tivanis/HVDiffprobe/Differential_Probe_v1r1.kicad_pcb

## KiCad design Differential_Probe_v1r1.kicad_pcb (2024-01-04)

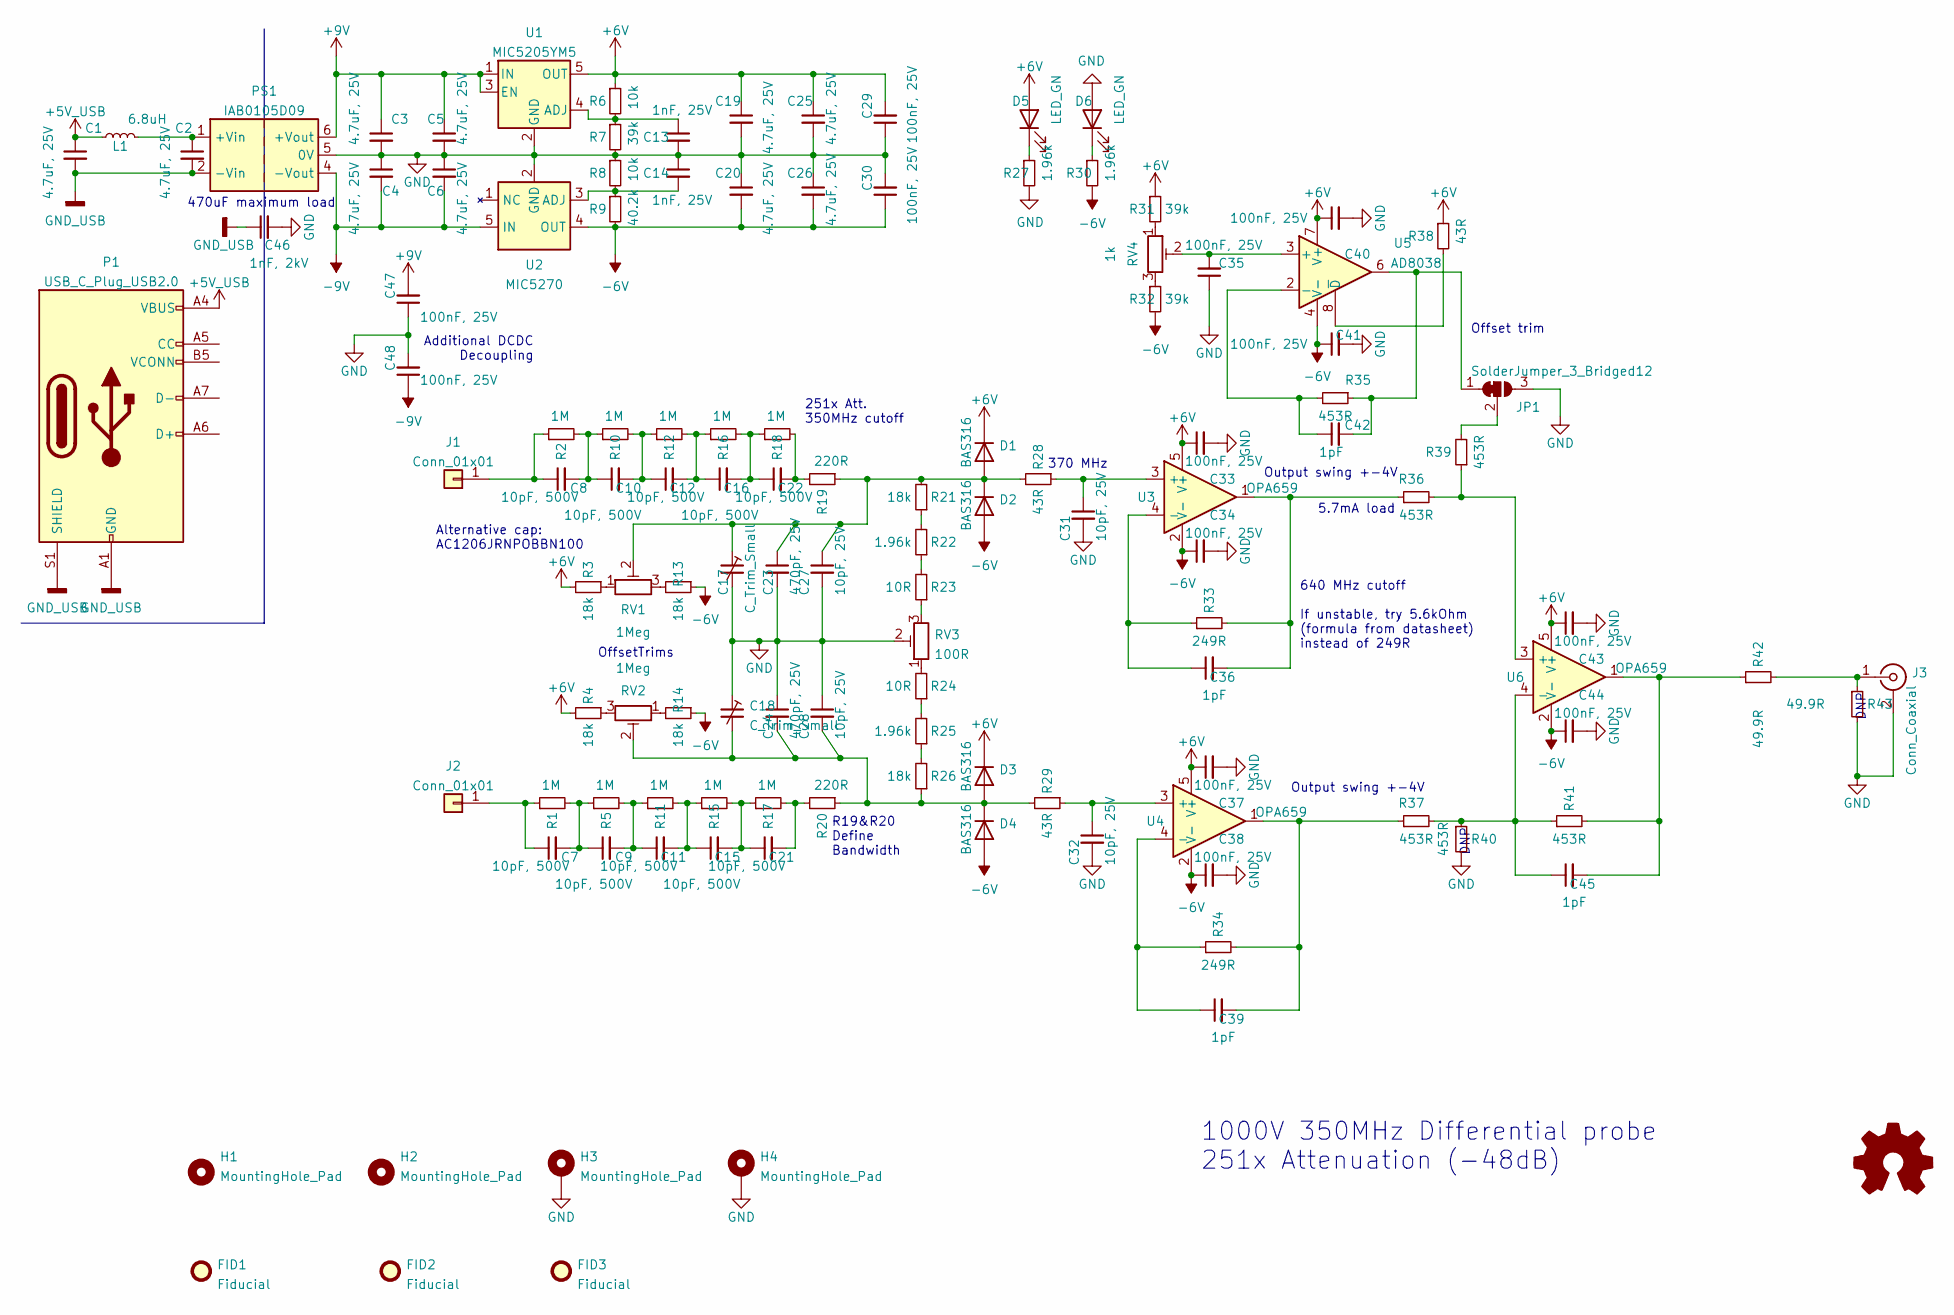
[picture p1: schematic Differential_Probe_v1r1.kicad_sch]

Parts:
C1, C2, C3, C4, C5, C6, C19, C20, C25, C26: 4.7uF, 25V; C_0805_2012Metric; Manufacturer Part Number TMK212BBJ475KGHT
C7, C8, C9, C10, C11, C12, C15, C16, C21, C22: 10pF, 500V; C_1206_3216Metric; Manufacturer Part Number 1206N100G501CT
C13, C14: 1nF, 25V; C_0603_1608Metric; Manufacturer Part Number C0603C102K3RAC
C17, C18: C_Trim_Small; C_Trimmer_Voltronics_JZ; Manufacturer Part Number JZ400
C23, C24: 470pF, 25V; C_0603_1608Metric; Manufacturer Part Number VJ0603A471GXXCW1BC
C27, C28, C31, C32: 10pF, 25V; C_0603_1608Metric; Manufacturer Part Number CL03C100DA3GNNC
C29, C30, C33, C34, C35, C37, C38, C40, C41, C43, C44, C47, C48: 100nF, 25V; C_0603_1608Metric; Manufacturer Part Number CC0603MRX7R8BB104
C36, C39, C42, C45: 1pF; C_0603_1608Metric; Manufacturer Part Number 06033A1R0CAT2A
C46: 1nF, 2kV; C_1812_4532Metric_Pad1.57x3.40mm_HandSolder; Manufacturer Part Number VJ2008Y102KXUSTX1
D1, D2, D3, D4: BAS316; D_SOD-323; Manufacturer Part Number BAS316,135
D5, D6: LED_GN; LED_0603_1608Metric; Manufacturer Part Number APT1608SGC
FID1, FID2, FID3: Fiducial; Fiducial_0.5mm_Mask1mm
H1, H2: MountingHole_Pad; MountingHole_3.2mm_M3
H3, H4: MountingHole_Pad; MountingHole_3.2mm_M3_Pad_Via
J1, J2: Conn_01x01; MountingHole_2.2mm_M2_Pad_Via
J3: Conn_Coaxial; BNC_MOLEX_73100-0154_Horizontal; Manufacturer Part Number 73100-0154
JP1: SolderJumper_3_Bridged12; SolderJumper-3_P1.3mm_Open_RoundedPad1.0x1.5mm
L1: 6.8uH; L_1008_2520Metric; Manufacturer Part Number VLS201610HBX-6R8M-1
P1: USB_C_Plug_USB2.0; USB_C_Receptacle_GCT_USB4085; Manufacturer Part Number USB4085-GF-A
PS1: IAB0105D09; Converter_DCDC_XP_POWER-IAxxxxS_THT; Manufacturer Part Number IAB0105D09
R1, R2, R5, R10, R11, R12, R15, R16, R17, R18: 1M; R_1206_3216Metric; Manufacturer Part Number KTR18EZPF1004
R3, R4, R13, R14, R21, R26: 18k; R_0603_1608Metric; Manufacturer Part Number CR0603-FX-1802ELF
R6, R8: 10k; R_0603_1608Metric; Manufacturer Part Number CR0603-FX-1501ELF
R7, R31, R32: 39k; R_0603_1608Metric; Manufacturer Part Number CR0603-FX-3902ELF
R9: 40.2k; R_0603_1608Metric; Manufacturer Part Number CR0603-FX-1501ELF
R19, R20: 220R; R_0603_1608Metric; Manufacturer Part Number ERJ-PA3F2200V
R22, R25, R27, R30: 1.96k; R_0603_1608Metric; Manufacturer Part Number CR0603-FX-1961ELF
R23, R24: 10R; R_0603_1608Metric; Manufacturer Part Number CR0603-FX-10R0ELF
R28, R29, R38: 43R; R_0603_1608Metric; Manufacturer Part Number CR0603-FX-43R0ELF
R33, R34: 249R; R_0603_1608Metric; Manufacturer Part Number CR0603-FX-2490ELF
R35, R36, R37, R39, R40, R41: 453R; R_0603_1608Metric; Manufacturer Part Number CR0603-FX-4530ELF
R42, R43: 49.9R; R_0603_1608Metric; Manufacturer Part Number CR0603-FX-43R0ELF
RV1, RV2: 1Meg; Potentiometer_Bourns_3314G_Vertical; Manufacturer Part Number TC33X-2-105G
RV3: 100R; Potentiometer_Bourns_3314G_Vertical; Manufacturer Part Number TC33X-2-101E
RV4: 1k; Potentiometer_Bourns_3314G_Vertical; Manufacturer Part Number TC33X-2-103G
U1: MIC5205YM5; SOT-23-5; Manufacturer Part Number MIC5205YM5
U2: MIC5270; SOT-23-5; Manufacturer Part Number MIC5270YM5-TR
U3, U4, U6: OPA659; SOT-23-5; Manufacturer Part Number OPA659IDBVT
U5: AD8038; SOIC-8_3.9x4.9mm_P1.27mm

Connections:
+5V_USB: C1.1, L1.1, P1.A4 (VBUS), P1.A9 (VBUS), P1.B4 (VBUS), P1.B9 (VBUS)
+6V: C19.1, C25.1, C29.2, C33.1, C37.1, C40.1, C43.1, D1.1 (K), D3.1 (K), D5.2 (A), R3.2, R4.2, R6.1, R31.1, R38.1, U1.5 (OUT), U3.5 (V+), U4.5 (V+), U5.7 (V+), U6.5 (V+)
+9V: C3.1, C5.1, C47.2, PS1.6 (+Vout), U1.1 (IN), U1.3 (EN)
-6V: C20.2, C26.2, C30.1, C34.1, C38.1, C41.1, C44.1, D2.2 (A), D4.2 (A), R9.2, R13.1, R14.1, R30.2, R32.2, U2.4 (OUT), U3.2 (V-), U4.2 (V-), U5.4 (V-), U6.2 (V-)
-9V: C4.2, C6.2, C48.1, PS1.4 (-Vout), U2.5 (IN)
GND: C3.2, C4.1, C5.2, C6.1, C13.2, C14.1, C17.2, C18.1, C19.2, C20.1, C23.2, C24.1, C25.2, C26.1, C27.2, C28.1, C29.1, C30.2, C31.2, C32.2, C33.2, C34.2, C35.1, C37.2, C38.2, C40.2, C41.2, C43.2, C44.2, C46.2, C47.1, C48.2, D6.2 (A), H3.1, H4.1, J3.2 (Ext), JP1.3 (B), PS1.5 (0V), R7.2, R8.1, R27.2, R40.2, R43.2, RV3.2, U1.2 (GND), U2.2 (GND)
GND_USB: C1.2, C2.2, C46.1, P1.A1 (GND), P1.A12 (GND), P1.B1 (GND), P1.B12 (GND), P1.S1 (SHIELD), PS1.2 (-Vin)
unnamed: C2.1, L1.2, PS1.1 (+Vin)
unnamed: C7.1, J2.1, R1.1
unnamed: C7.2, C9.1, R1.2, R5.1
unnamed: C8.1, J1.1, R2.1
unnamed: C8.2, C10.1, R2.2, R10.1
unnamed: C10.2, C12.1, R10.2, R12.1
unnamed: C9.2, C11.1, R5.2, R11.1
unnamed: C11.2, C15.1, R11.2, R15.1
unnamed: C12.2, C16.1, R12.2, R16.1
unnamed: C13.1, R6.2, R7.1, U1.4 (ADJ)
unnamed: C14.2, R8.2, R9.1, U2.3 (ADJ)
unnamed: C15.2, C21.1, R15.2, R17.1
unnamed: C16.2, C22.1, R16.2, R18.1
unnamed: C17.1, C23.1, C27.1, D1.2 (A), D2.1 (K), R19.1, R21.2, R28.2, RV1.2
unnamed: C18.2, C24.2, C28.2, D3.2 (A), D4.1 (K), R20.1, R26.1, R29.2, RV2.2
unnamed: C21.2, R17.2, R20.2
unnamed: C22.2, R18.2, R19.2
unnamed: C31.1, R28.1, U3.3 (+)
unnamed: C32.1, R29.1, U4.3 (+)
unnamed: C35.2, RV4.2, U5.3 (+)
unnamed: C36.1, R33.1, U3.4 (-)
unnamed: C36.2, R33.2, R36.1, U3.1
unnamed: C39.1, R34.1, U4.4 (-)
unnamed: C39.2, R34.2, R37.1, U4.1
unnamed: C42.1, R35.2, U5.2 (-)
unnamed: C42.2, JP1.1 (A), R35.1, U5.6
unnamed: C45.1, R37.2, R40.1, R41.1, U6.4 (-)
unnamed: C45.2, R41.2, R42.1, U6.1
unnamed: D5.1 (K), R27.1
unnamed: D6.1 (K), R30.1
unnamed: J3.1 (In), R42.2, R43.1
unnamed: JP1.2 (C), R39.2
unnamed: R3.1, RV1.1
unnamed: R4.1, RV2.3
unnamed: R13.2, RV1.3
unnamed: R14.2, RV2.1
unnamed: R21.1, R22.2
unnamed: R22.1, R23.2
unnamed: R23.1, RV3.3
unnamed: R24.1, R25.2
unnamed: R24.2, RV3.1
unnamed: R25.1, R26.2
unnamed: R31.2, RV4.1
unnamed: R32.1, RV4.3
unnamed: R36.2, R39.1, U6.3 (+)
unnamed: R38.2, U5.8 (~D)

Notes on the sheet:
370 MHz
470uF maximum load
R19&R20 Define Bandwidth
DNP
Offset trim
1000V 350MHz Differential probe 251x Attenuation (-48dB)
5.7mA load
Additional DCDC Decoupling
Alternative cap: AC1206JRNPOBBN100
Output swing +-4V
640 MHz cutoff If unstable, try 5.6kOhm (formula from datasheet) instead of 249R
251x Att. 350MHz cutoff
OffsetTrims

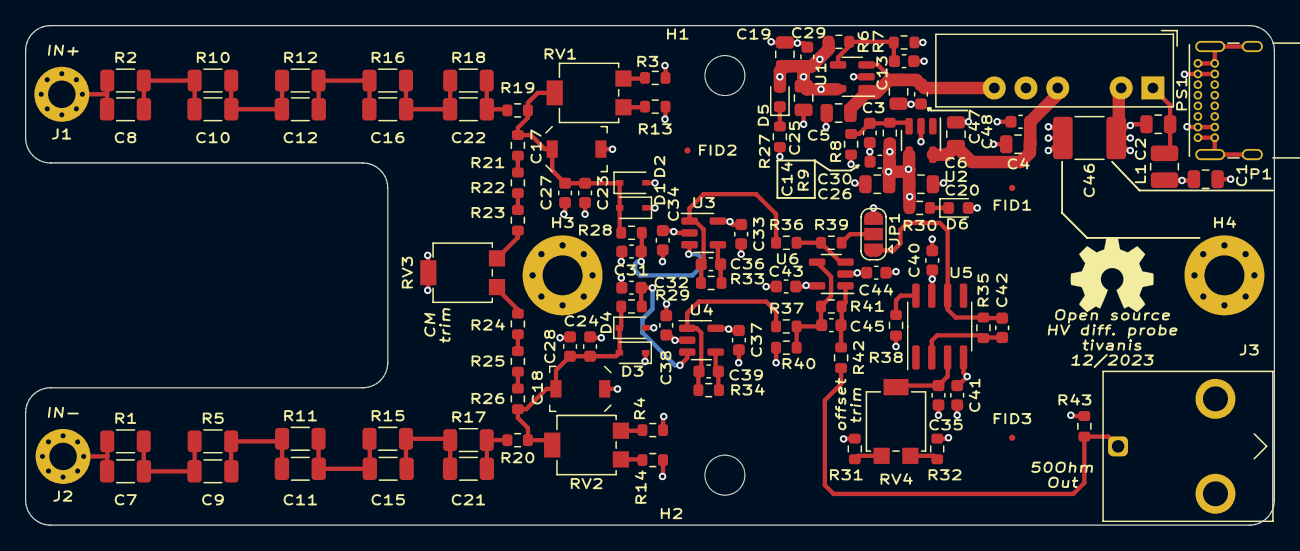
[picture p2: board Differential_Probe_v1r1.kicad_pcb from above]

Board: 4 copper layers, 100.0 x 40.0 mm, 121 parts (0 on the bottom side), 53 nets.
